gggioe/Datalogger/README.md

# Datalogger
Esp32 voltage/current logger
