gggioe/Datalogger/Hardware/power_logger.kicad_pcb

## KiCad design Hardware/power_logger.kicad_pcb (2026-04-21)

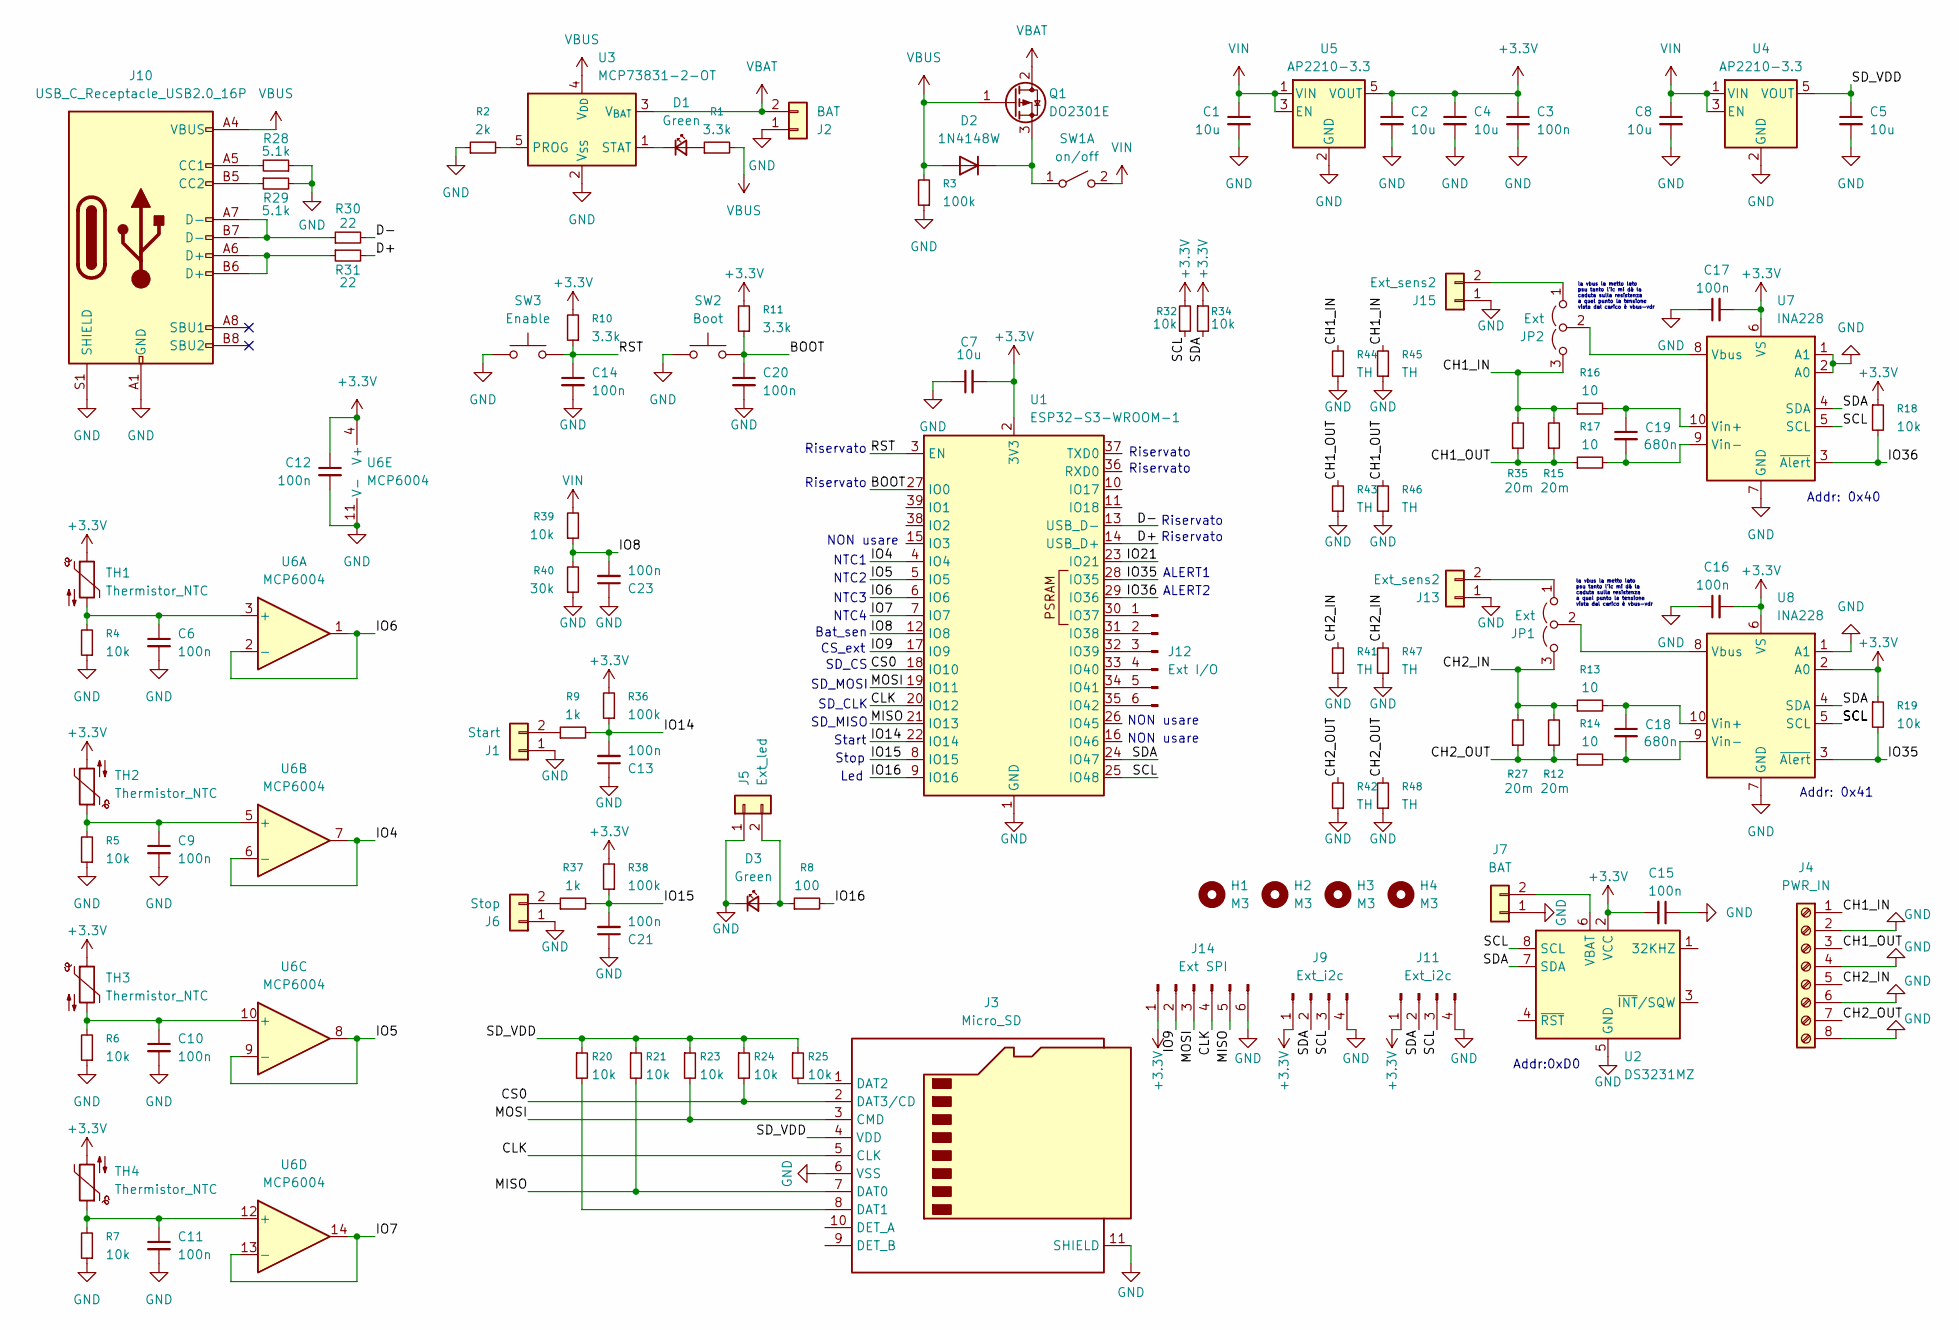
[picture p1: schematic power_logger.kicad_sch]

Parts:
C1, C2, C4, C5, C7, C8: 10u; C_0603_1608Metric_Pad1.08x0.95mm_HandSolder
C3, C6, C9, C10, C11, C12, C13, C14, C15, C16, C17, C20, C21, C23: 100n; C_0603_1608Metric_Pad1.08x0.95mm_HandSolder
C18, C19: 680n; C_0603_1608Metric_Pad1.08x0.95mm_HandSolder
D1, D3: Green; LED_0603_1608Metric_Pad1.05x0.95mm_HandSolder
D2: 1N4148W; D_SOD-123
H1, H2, H3, H4: M3; MountingHole_3.2mm_M3
J1: Start; JST_PH_B2B-PH-K_1x02_P2.00mm_Vertical
J2, J7: BAT; JST_PH_B2B-PH-K_1x02_P2.00mm_Vertical
J3: Micro_SD; microSD_HC_Molex_104031-0811_Handsolder
J4: PWR_IN; TerminalBlock_MaiXu_MX126-5.0-08P_1x08_P5.00mm
J5: Ext_led; JST_PH_B2B-PH-K_1x02_P2.00mm_Vertical
J6: Stop; JST_PH_B2B-PH-K_1x02_P2.00mm_Vertical
J9, J11: Ext_i2c; JST_PH_B4B-PH-K_1x04_P2.00mm_Vertical
J10: USB_C_Receptacle_USB2.0_16P; USB_C_Receptacle_G-Switch_GT-USB-7010ASV
J12: Ext I/O; JST_PH_B6B-PH-K_1x06_P2.00mm_Vertical
J13, J15: Ext_sens2; JST_PH_B2B-PH-K_1x02_P2.00mm_Vertical
J14: Ext SPI; JST_PH_B6B-PH-K_1x06_P2.00mm_Vertical
JP1, JP2: Ext; SolderJumper-3_P1.3mm_Open_RoundedPad1.0x1.5mm_NumberLabels
Q1: DO2301E; TSOT-23_HandSoldering
R1, R10, R11: 3.3k; R_0603_1608Metric_Pad0.98x0.95mm_HandSolder
R2: 2k; R_0603_1608Metric_Pad0.98x0.95mm_HandSolder
R3, R36, R38: 100k; R_0603_1608Metric_Pad0.98x0.95mm_HandSolder
R4, R5, R6, R7, R18, R19, R20, R21, R23, R24, R25, R32, R34, R39: 10k; R_0603_1608Metric_Pad0.98x0.95mm_HandSolder
R8: 100; R_0603_1608Metric_Pad0.98x0.95mm_HandSolder
R9, R37: 1k; R_0603_1608Metric_Pad0.98x0.95mm_HandSolder
R12, R15, R27, R35: 20m; RESC6772X124N
R13, R14, R16, R17: 10; R_0603_1608Metric_Pad0.98x0.95mm_HandSolder
R28, R29: 5.1k; R_0603_1608Metric_Pad0.98x0.95mm_HandSolder
R30, R31: 22; R_0603_1608Metric_Pad0.98x0.95mm_HandSolder
R40: 30k; R_0603_1608Metric_Pad0.98x0.95mm_HandSolder
R41, R42, R43, R44, R45, R46, R47, R48: TH; R_2512_6332Metric_Pad1.40x3.35mm_HandSolder
SW1: on/off; JST_PH_B2B-PH-K_1x02_P2.00mm_Vertical
SW2: Boot; SW_SPST_SKQG_WithStem
SW3: Enable; SW_SPST_SKQG_WithStem
TH1, TH2, TH3, TH4: Thermistor_NTC; JST_PH_B2B-PH-K_1x02_P2.00mm_Vertical
U1: ESP32-S3-WROOM-1
U2: DS3231MZ; SOIC-8_3.9x4.9mm_P1.27mm
U3: MCP73831-2-OT; SOT-23-5
U4, U5: AP2210-3.3; SOT-23-5
U6: MCP6004; SOIC-14_3.9x8.7mm_P1.27mm
U7, U8: INA228; VSSOP-10_3x3mm_P0.5mm

Connections:
+3.3V: C2.1, C3.1, C4.1, C7.2, C12.1, C15.2, C16.2, C17.2, J9.1, J11.1, J14.1, R10.2, R11.2, R18.1, R19.1, R32.2, R34.1, R36.2, R38.2, TH1.1, TH2.2, TH3.1, TH4.2, U1.2 (3V3), U2.2 (VCC), U5.5 (VOUT), U6.4 (V+), U7.6 (VS), U8.2 (A0), U8.6 (VS); also elsewhere on the board
/BOOT: C20.1, R11.1, SW2.2, U1.27 (IO0)
/CH1_IN: J4.1, JP2.3 (B), R15.2, R16.1, R35.2, R44.2, R45.2
/CH1_OUT: J4.3, R15.1, R17.1, R35.1, R43.2, R46.2
/CH2_IN: J4.5, JP1.3 (B), R12.2, R13.1, R27.2, R41.2, R47.2
/CH2_OUT: J4.7, R12.1, R14.1, R27.1, R42.2, R48.2
/CLK: J3.5 (CLK), J14.4, U1.20 (IO12); also elsewhere on the board
/CS0: J3.2 (DAT3/CD), R24.2, U1.18 (IO10)
/D+: R31.2, U1.14 (USB_D+)
/D-: R30.2, U1.13 (USB_D-)
/IO4: U1.4 (IO4), U6.6 (-), U6.7
/IO5: U1.5 (IO5), U6.8, U6.9 (-)
/IO6: U1.6 (IO6), U6.1, U6.2 (-)
/IO7: U1.7 (IO7), U6.13 (-), U6.14
/IO8: C23.2, R39.1, R40.2, U1.12 (IO8)
/IO9: J14.2, U1.17 (IO9)
/IO14: C13.2, R9.2, R36.1, U1.22 (IO14)
/IO15: C21.2, R37.2, R38.1, U1.8 (IO15)
/IO16: R8.2, U1.9 (IO16)
/IO21: U1.23 (IO21)
/IO35: R19.2, U1.28 (IO35), U8.3 (~Alert)
/IO36: R18.2, U1.29 (IO36), U7.3 (~Alert)
/MISO: J3.7 (DAT0), J14.5, R21.2, U1.21 (IO13)
/MOSI: J3.3 (CMD), J14.3, R23.2, U1.19 (IO11)
/RST: C14.1, R10.1, SW3.2, U1.3 (EN)
/SCL: J9.3, J11.3, R32.1, U1.25 (IO48), U2.8 (SCL), U7.5 (SCL), U8.5 (SCL)
/SDA: J9.2, J11.2, R34.2, U1.24 (IO47), U2.7 (SDA), U7.4 (SDA), U8.4 (SDA)
/SD_VDD: C5.1, J3.4 (VDD), R20.1, R21.1, R23.1, R24.1, R25.1, U4.5 (VOUT); also elsewhere on the board
GND: C1.2, C2.2, C3.2, C4.2, C5.2, C6.2, C7.1, C8.2, C9.2, C10.2, C11.2, C12.2, C13.1, C14.2, C15.1, C16.1, C17.1, C20.2, C21.1, C23.1, D3.1 (K), J1.1, J2.1, J3.6 (VSS), J3.11 (SHIELD), J4.2, J4.4, J4.6, J4.8, J5.1, J6.1, J7.1, J9.4, J10.A1 (GND), J10.A12 (GND), J10.B1 (GND), J10.B12 (GND), J10.S1 (SHIELD), J11.4, J13.1, J14.6, J15.1, R2.1, R3.1, R4.1, R5.1, R6.1, R7.1, R28.1, R29.2, R40.1, R41.1, R42.1, R43.1, R44.1, R45.1, R46.1, R47.1, R48.1, SW2.1, SW3.1, U1.1 (GND), U1.40 (GND), U1.41 (GND), U2.5 (GND), U3.2 (V_{SS}), U4.2 (GND), U5.2 (GND), U6.11 (V-), U7.1 (A1), U7.2 (A0), U7.7 (GND), U8.1 (A1), U8.7 (GND); also elsewhere on the board
unnamed: D1.2 (A), R1.1
unnamed: D1.1 (K), U3.1 (STAT)
unnamed: D2.1 (K), Q1.3 (S), SW1.1 (A)
unnamed: D3.2 (A), J5.2, R8.1
unnamed: J1.2, R9.1
unnamed: J3.8 (DAT1), R20.2
unnamed: J3.1 (DAT2), R25.2
unnamed 36: J3.10 (DET_A); also elsewhere on the board
unnamed 37: J3.9 (DET_B); also elsewhere on the board
unnamed: J6.2, R37.1
unnamed: J7.2, U2.6 (VBAT)
unnamed: J10.A5 (CC1), R28.2
unnamed: J10.B5 (CC2), R29.1
unnamed: J10.A6 (D+), J10.B6 (D+), R31.1
unnamed: J10.A7 (D-), J10.B7 (D-), R30.1
unnamed: J12.1, U1.30 (IO37)
unnamed: J12.2, U1.31 (IO38)
unnamed: J12.3, U1.32 (IO39)
unnamed: J12.4, U1.33 (IO40)
unnamed: J12.5, U1.34 (IO41)
unnamed: J12.6, U1.35 (IO42)
unnamed: J13.2, JP1.1 (A)
unnamed: J15.2, JP2.1 (A)
unnamed: JP1.2 (C), U8.8 (Vbus)
unnamed: JP2.2 (C), U7.8 (Vbus)
unnamed: R2.2, U3.5 (PROG)
unnamed: C6.1, R4.2, TH1.2, U6.3 (+)
unnamed: C9.1, R5.2, TH2.1, U6.5 (+)
unnamed: C10.1, R6.2, TH3.2, U6.10 (+)
unnamed: C11.1, R7.2, TH4.1, U6.12 (+)
unnamed: C19.1, R16.2, U7.10 (Vin+)
unnamed: C19.2, R17.2, U7.9 (Vin-)
unnamed: C18.1, R13.2, U8.10 (Vin+)
unnamed: C18.2, R14.2, U8.9 (Vin-)
VBAT: J2.2, Q1.2 (D), U3.3 (V_{BAT})
VBUS: D2.2 (A), J10.A4 (VBUS), J10.A9 (VBUS), J10.B4 (VBUS), J10.B9 (VBUS), Q1.1 (G), R1.2, R3.2, U3.4 (V_{DD})
VIN: C1.1, C8.1, R39.2, SW1.2 (B), U4.1 (VIN), U4.3 (EN), U5.1 (VIN), U5.3 (EN)

Notes on the sheet:
SD_CLK
NTC2
NON usare
Riservato
SD_MOSI
Led
la vbus la metto lato psu tanto l'ic mi dà la caduta sulla resistenza a quel punto la tensione vista dal carico è vbus-vdr
Addr: 0x40
NTC1
Addr:0xD0
ALERT2
Start
ALERT1
NTC4
SD_CS
Bat_sen
CS_ext
Addr: 0x41
SD_MISO
NTC3
Stop

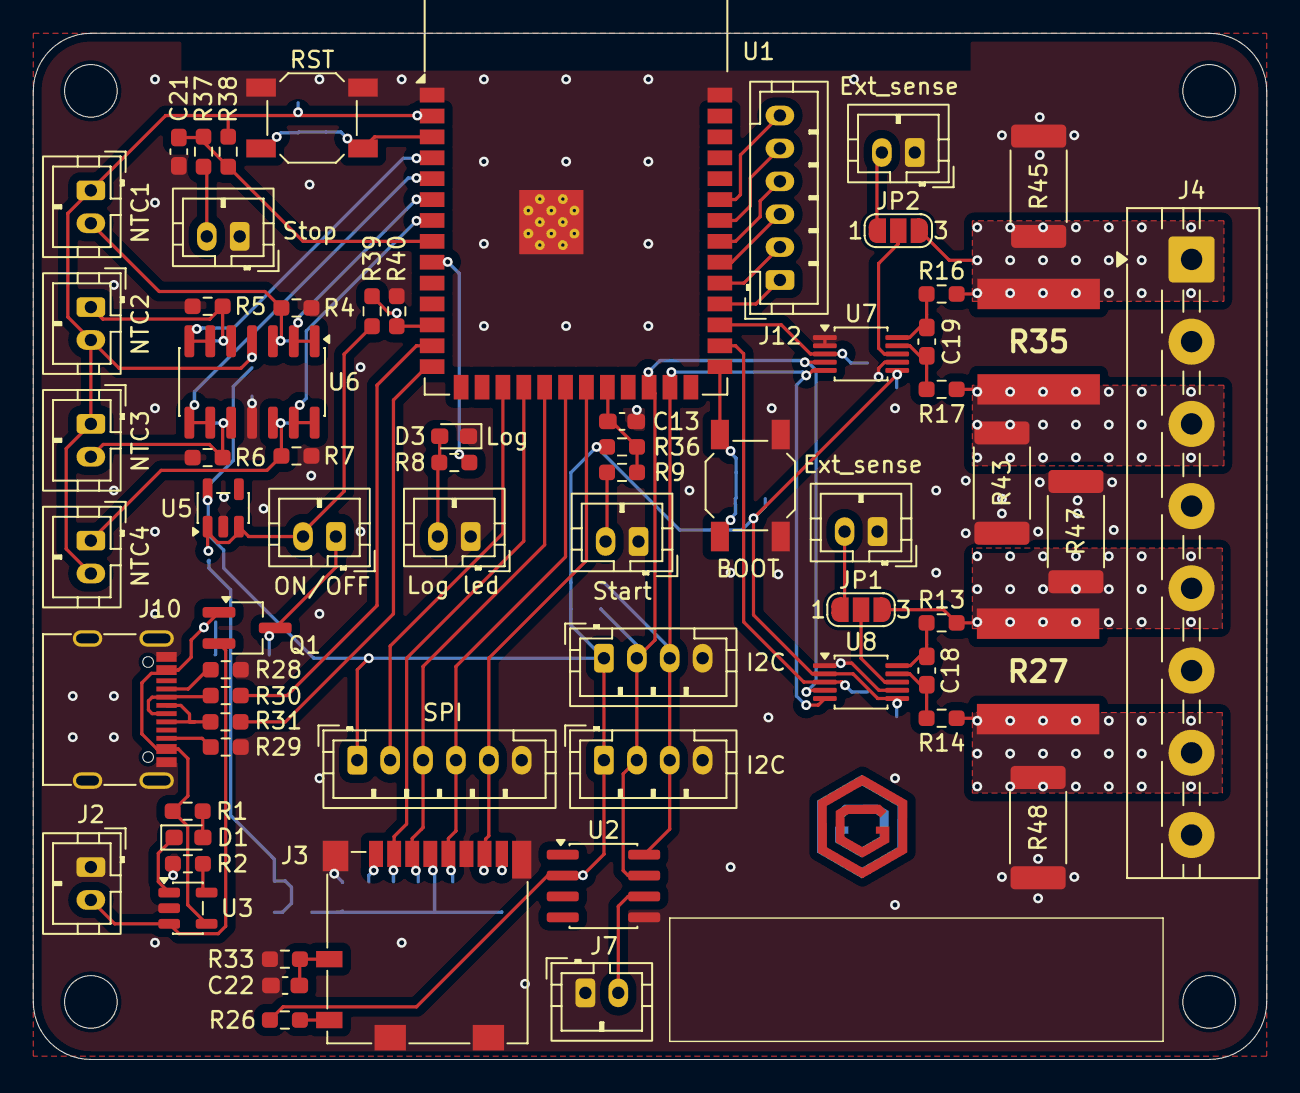
[picture p2: board power_logger.kicad_pcb from above]

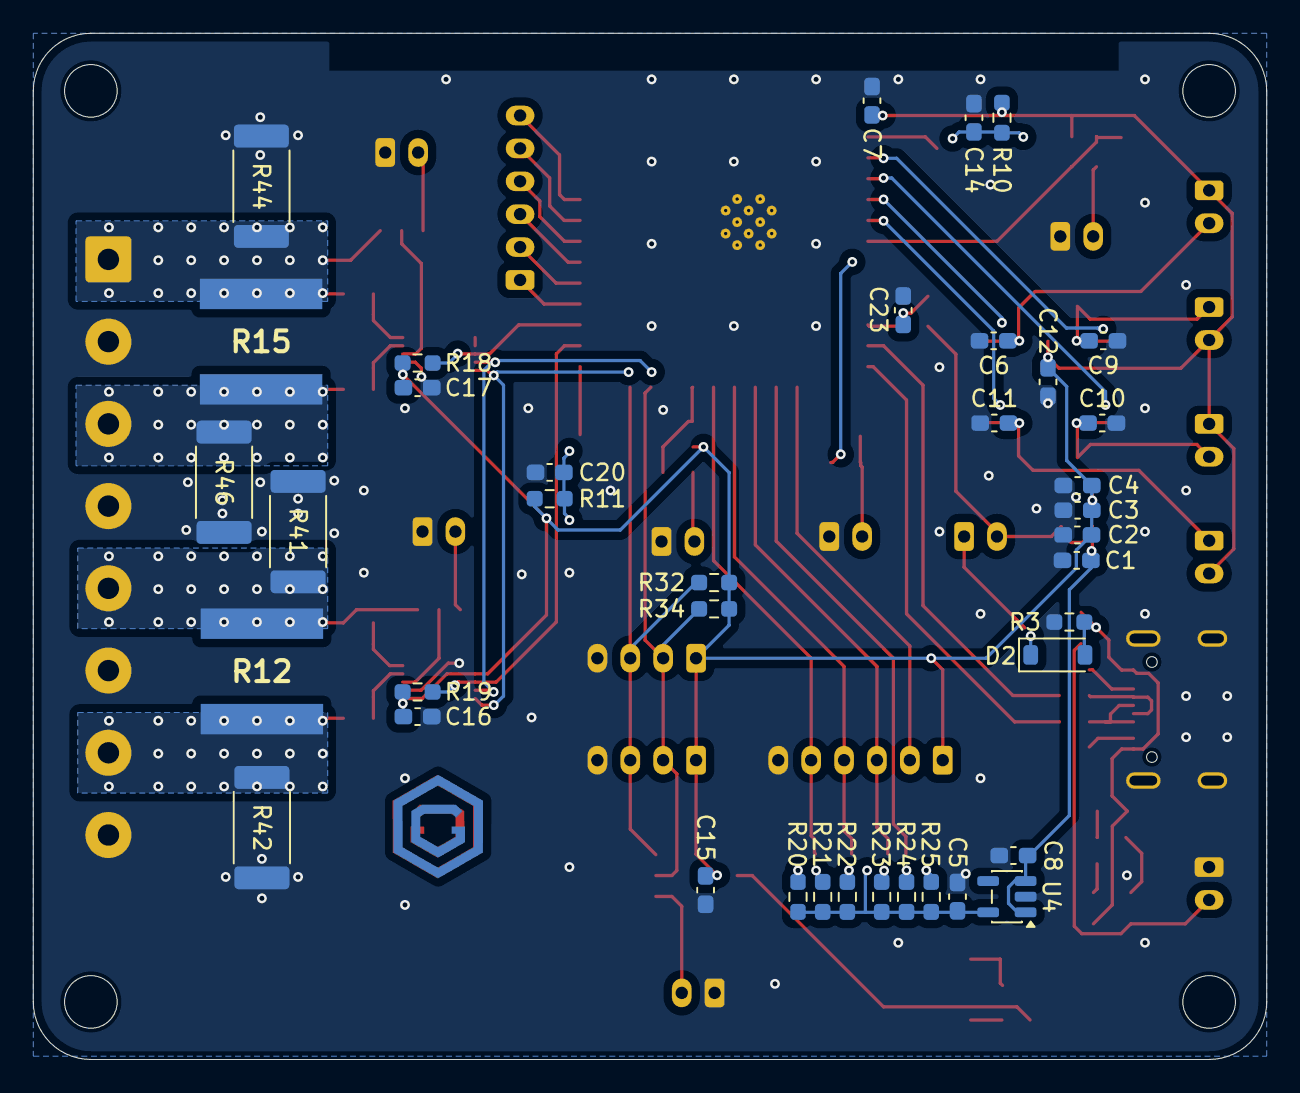
[picture p3: board power_logger.kicad_pcb from below]

Board: 2 copper layers, 75.0 x 62.4 mm, 110 parts (39 on the bottom side), 65 nets.

Other parts of the board:
C22: 1u; C_0603_1608Metric_Pad1.08x0.95mm_HandSolder
R22, R33: 10k; R_0603_1608Metric_Pad0.98x0.95mm_HandSolder
R26: 1k; R_0603_1608Metric_Pad0.98x0.95mm_HandSolder

Their connections:
+3.3V: R26.1; also elsewhere on the board
/CLK: R22.2; also elsewhere on the board
/SD_VDD: R22.1; also elsewhere on the board
GND: C22.2, R33.2; also elsewhere on the board
unnamed 36: R26.2; also elsewhere on the board
unnamed 37: C22.1, R33.1; also elsewhere on the board
