gggioe/Datalogger/(commit log)

2026-04-21 Added hardware rev1.0
    [power_logger-B_Cu.gbr, power_logger-B_Mask.gbr, power_logger-B_Paste.gbr, power_logger-B_Silkscreen.gbr, power_logger-Edge_Cuts.gbr, power_logger-F_Cu.gbr, power_logger-F_Mask.gbr, power_logger-F_Paste.gbr]
2026-04-21 added menu switch
